jbgoldst/Hermes-Project/README.md

Hermes-Project
==============
Self-localizing robot that autonomously navigates a building in minimum time.
HERMES stands for "Heuristic Expeditionary Range-finding Motion-analyzing Electronic System."
