jbgoldst/Hermes-Project/(commit log)

2014-11-20 Motor Code
2014-11-20 Encoder Code
2014-11-20 Laser Range Finder Code
